peterwishart/OS-ARM/cad/FirstDraft/Link1.stl

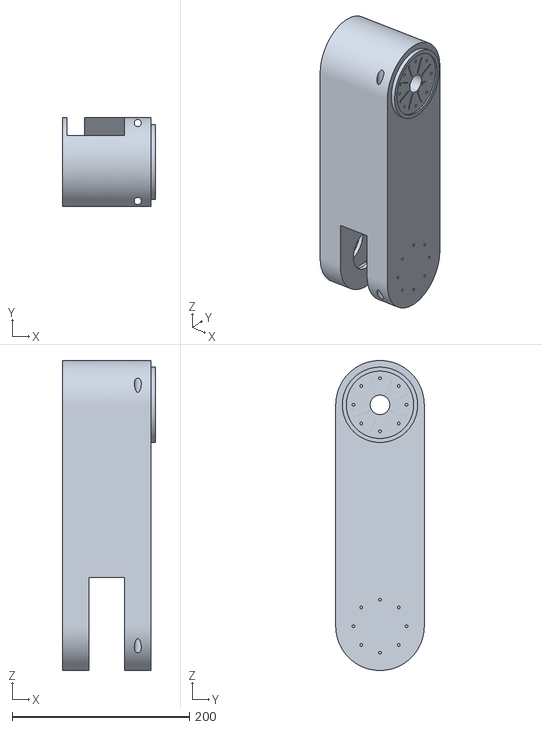
[picture p1: CAD file, 2021-06-03]
cad/FirstDraft/Link1.stl
105.0 x 100.0 x 350.0
