peterwishart/OS-ARM/cad/HarmonicDrive75mm/HD_rotorMachined.stp

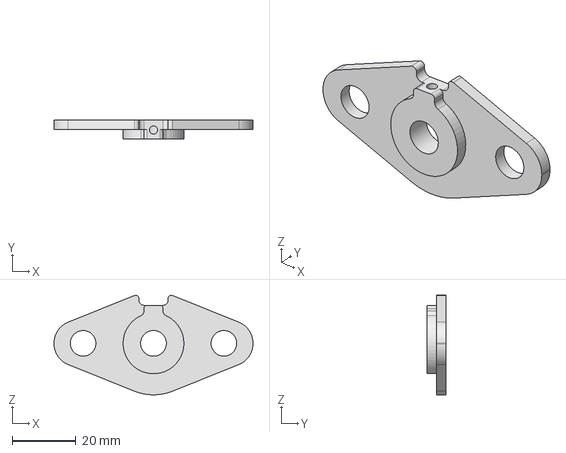
[picture p2: CAD file, 2021-06-03]
cad/HarmonicDrive75mm/HD_rotorMachined.stp
62.2 x 6.00 x 31.1 mm
