peterwishart/OS-ARM/cad/HarmonicDrive75mm/HD_rotor_0635mmShaft.stl

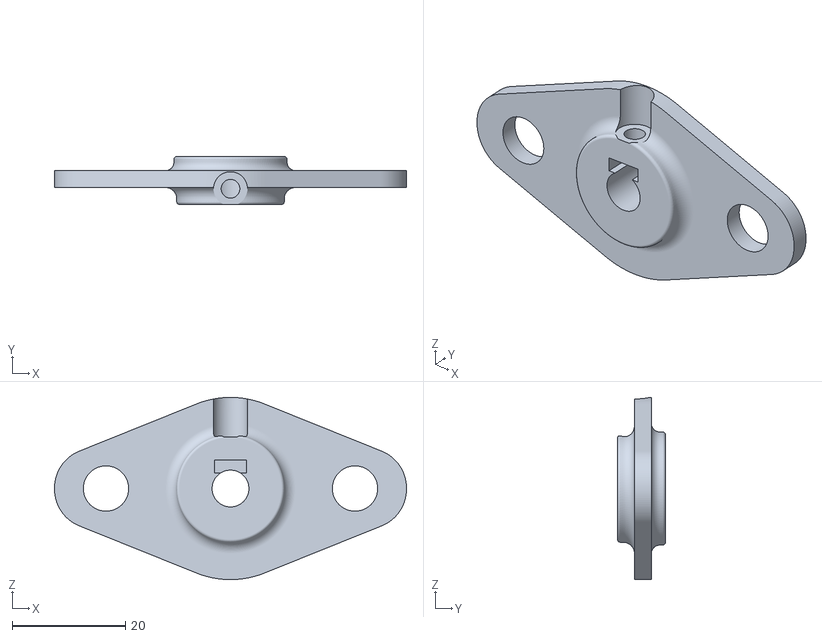
[picture p3: CAD file, 2021-06-03]
cad/HarmonicDrive75mm/HD_rotor_0635mmShaft.stl
62.2 x 8.50 x 32.2
