peterwishart/OS-ARM/cad/HarmonicDrive75mm/HD_rotor_Gt2.stl

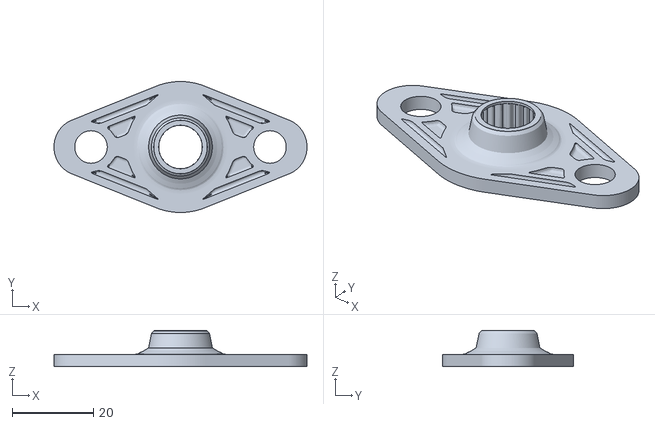
[picture p4: CAD file, 2021-06-03]
cad/HarmonicDrive75mm/HD_rotor_Gt2.stl
62.2 x 32.2 x 8.89
