peterwishart/OS-ARM/cad/HarmonicDrive75mm/HD_housing2.stl

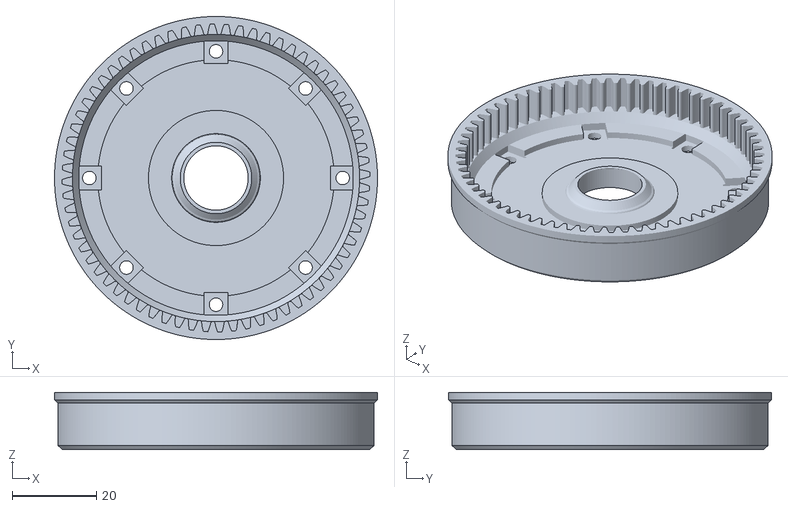
[picture p5: CAD file, 2021-05-28]
cad/HarmonicDrive75mm/HD_housing2.stl
76.5 x 76.5 x 13.5
