peterwishart/OS-ARM/cad/HarmonicDrive75mm/HD_housing.stl

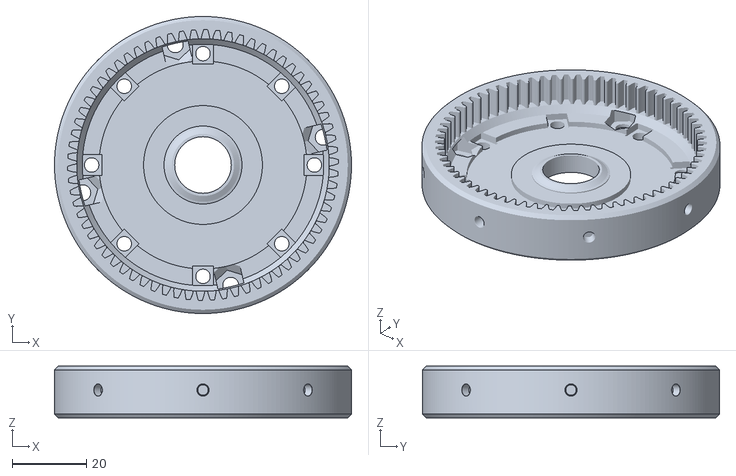
[picture p6: CAD file, 2021-05-28]
cad/HarmonicDrive75mm/HD_housing.stl
80.0 x 80.0 x 14.0
