peterwishart/OS-ARM/(list of files, cad)

Other CAD files:
cad/FirstDraft/DraftAssembly.iam
cad/FirstDraft/J1_Drive.iam
cad/FirstDraft/Link1.ipt
cad/FirstDraft/Link2.ipt
cad/FirstDraft/Link3.ipt
cad/FirstDraft/OldVersions/DraftAssembly.0034.iam
cad/FirstDraft/OldVersions/J1_Drive.0026.iam
cad/FirstDraft/OldVersions/Link1.0022.ipt
cad/FirstDraft/OldVersions/Link2.0013.ipt
cad/FirstDraft/OldVersions/Link3.0004.ipt
cad/HarmonicDrive75mm/HD_rotorMachined.ipt
cad/HarmonicDrive75mm/HD_rotor_0635mmShaft.ipt
cad/HarmonicDrive75mm/HarmonicDrive75mm.iam
cad/HarmonicDrive75mm/OldVersions/HD_rotorMachined.0037.ipt
cad/HarmonicDrive75mm/OldVersions/HD_rotor_0635mmShaft.0037.ipt
cad/HarmonicDrive75mm/OldVersions/HarmonicDrive75mm.0070.iam
cad/OTS/CF Tube 8x10x250.ipt
cad/OTS/OldVersions/CF Tube 8x10x250.0002.ipt
