peterwishart/OS-ARM/(commit log)

2021-05-28 Initial tweaks
    [HD_housing.stl, HD_housing2.stl, HD_rotor.stl]
2021-06-03 Fixed gt2 rotor
    [HD_rotor.stl, HD_rotor_Gt2.stl]
